wtremmel/MQTTClient/README.md

# MQTTClient
ESP8266 MQTT Client for sensor reading

# Hardware
## Supported Sensors
* BME280 - Temperature, humidity, air pressure
* BME680 - Temperature, humidity, air pressure, air quality
* GY49 - light level
* TSL2561 - light level
* TSL45315 - light level
* VEML6070 - UV light level
* SI7021 - Temperature, humidity
* SDS011 - dust (via soft serial interface)
* ADXL345 - acceleration
* ADC1115 - A/D converter

## Other supported hardware
* DS3221 - Real Time Clock
* Neopixel RGB LEDs

## Parts List Indoor Version
* ESP8266 Microcontroller incl. USB port for easier programming
* BME280 Temperature/Pressure/Humidity Sensor
* TSL2561 Light sensor
* WS2812 RGP LEDs (as many as you need)
* PIR motion sensor (not used in Example)
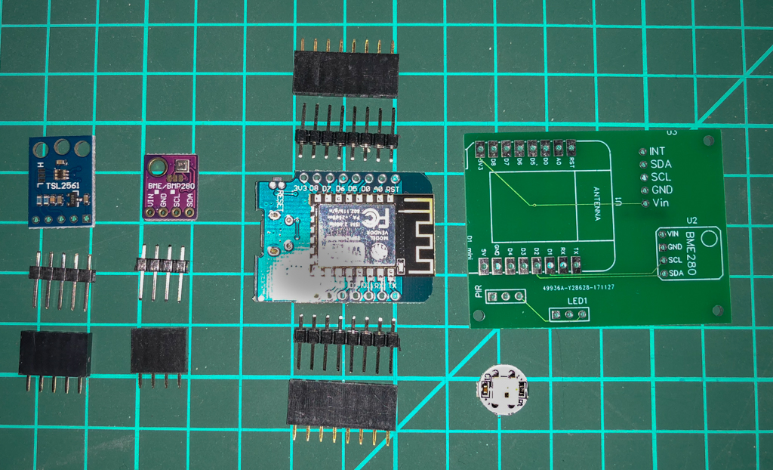
[picture p1: pictures/wt-mqttclient-13.jpg]
Parts
* See parts photo 

## Parts List Outdoor Version
* ESP8266 Microcontroller incl. USB port for easier programming
* BME280 Temperature/Pressure/Humidity Sensor
* TSL45315 Light sensor
* Solar panel 3-5W (the lower the voltage the better)
* Battery holder for two AA cells
* Two AA Eneloop cells (enough for three cloudy days)
* 3.3V step down converter (depending on solar panel used)
* 3.3V voltage regulator (to prevent battery discharge via the regulator)

# Soldering
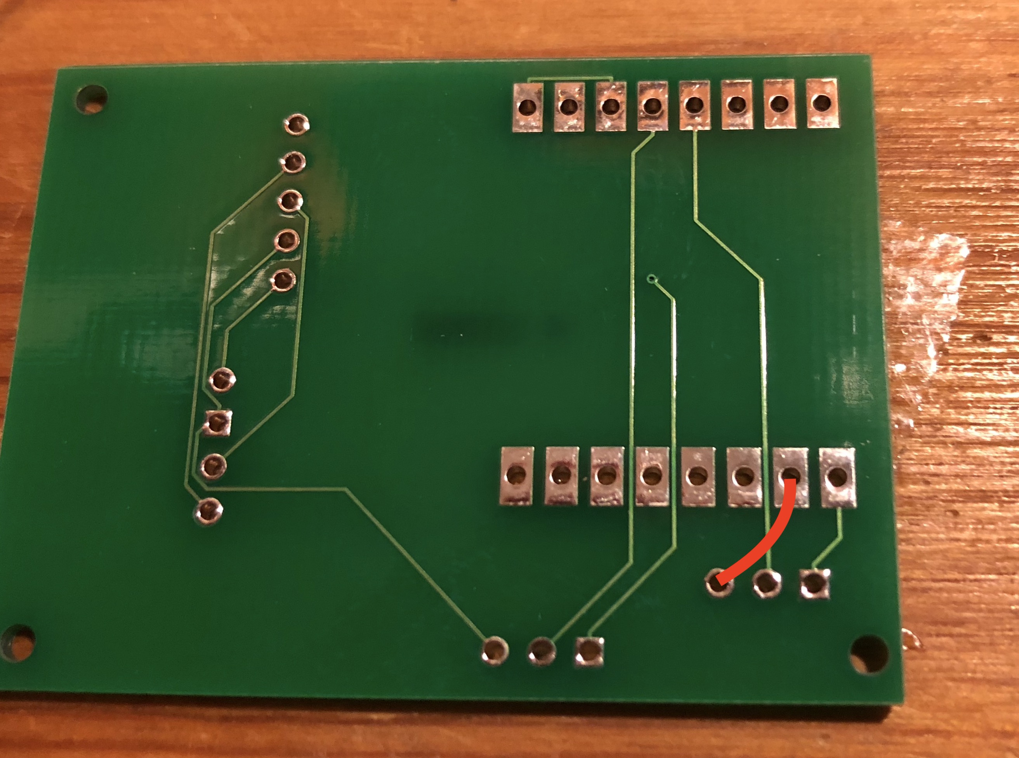
[picture p2: pictures/wt-mqttclient-18.jpg]
Forgotten wire
PIR is not used in this example. Because I made a mistake with the PCB board, you must solder a wire from the D1mini GND pin to the GND pin of the sensors. 

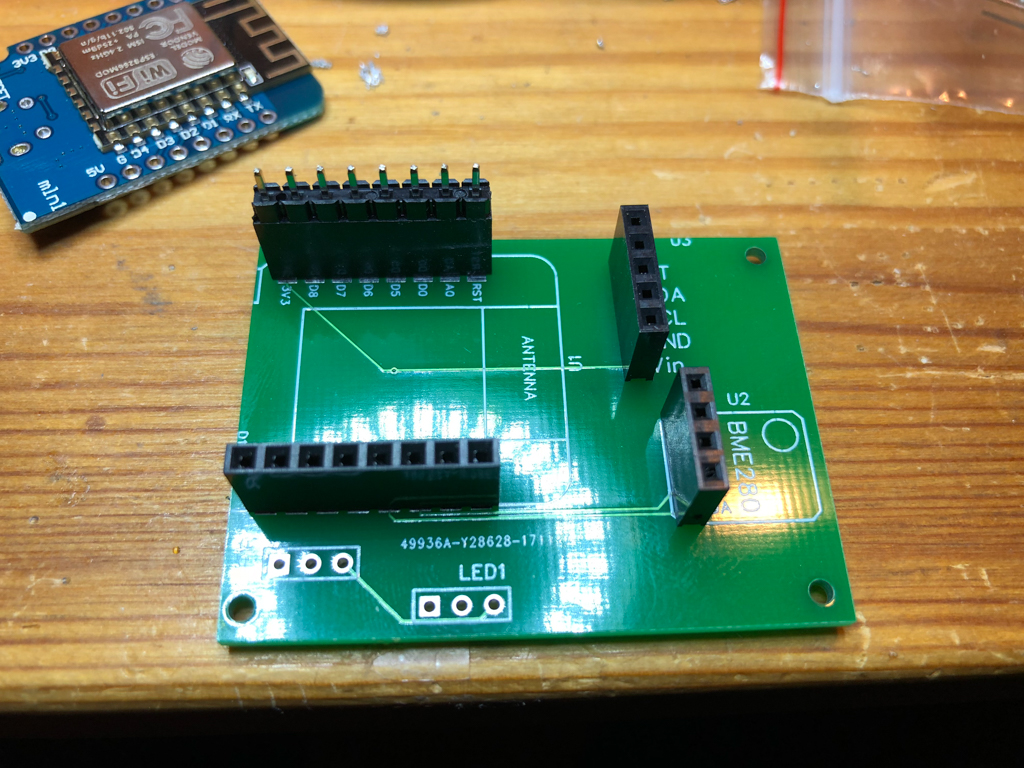
[picture p3: pictures/wt-mqttclient-14.jpg]
Pin Headers
1. First solder the pin headers 
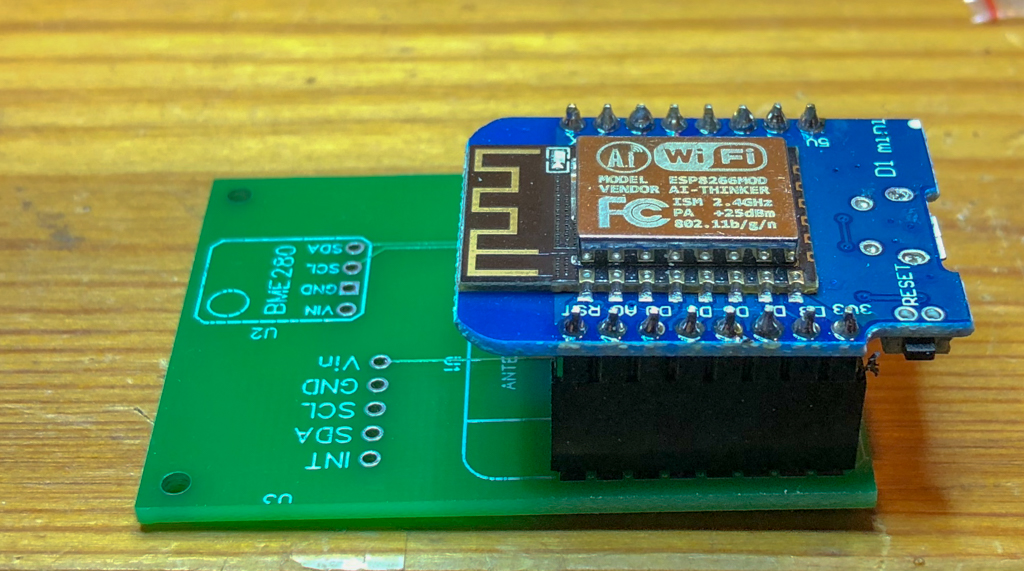
[picture p4: pictures/wt-mqttclient-12.jpg]
D1mini
2. Next plug in the D1mini including the male pin headers and solder the male pin headers to the D1mini from the top 
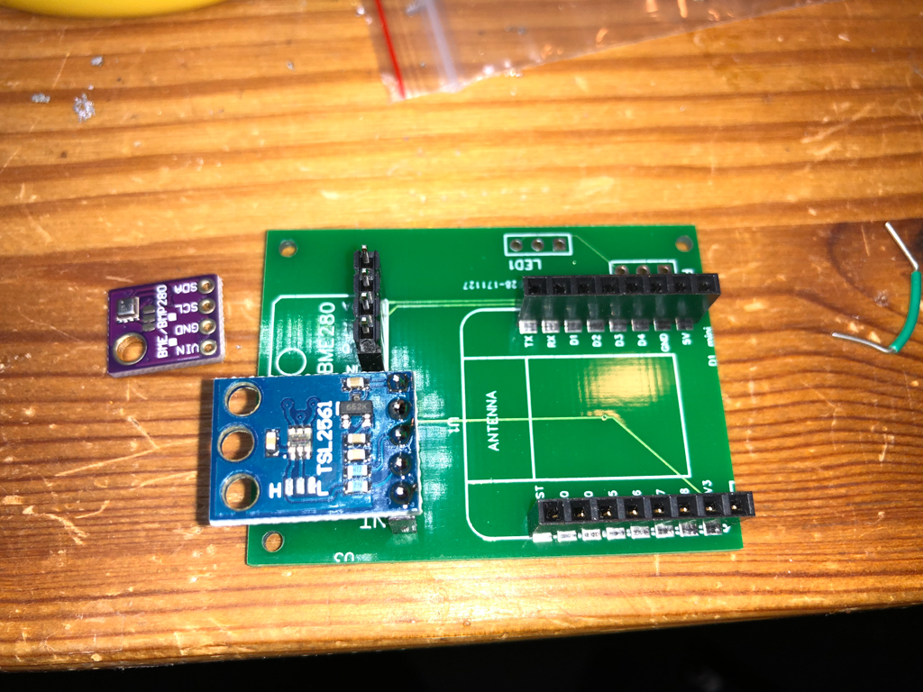
[picture p5: pictures/wt-mqttclient-15.jpg]
Sensors
3. Do the same with the two sensors 
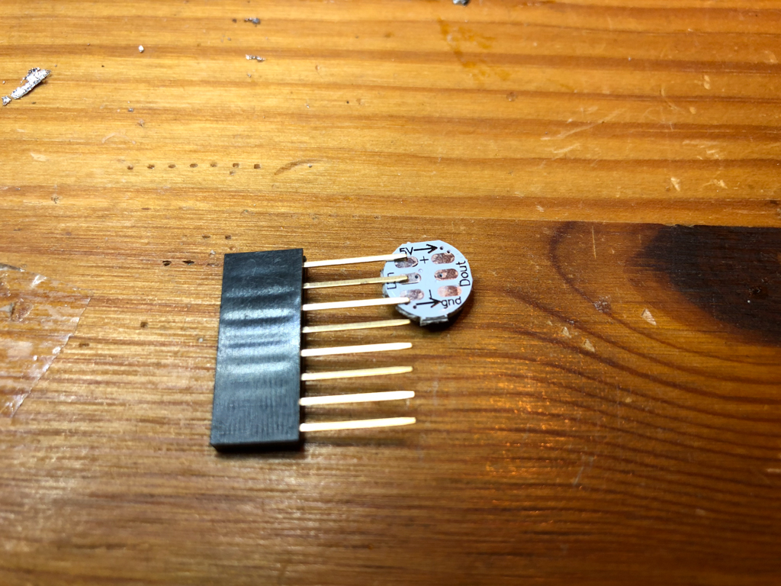
[picture p6: pictures/wt-mqttclient-16.jpg]
LED
4. Depending on what type of LED you have solder the LED 
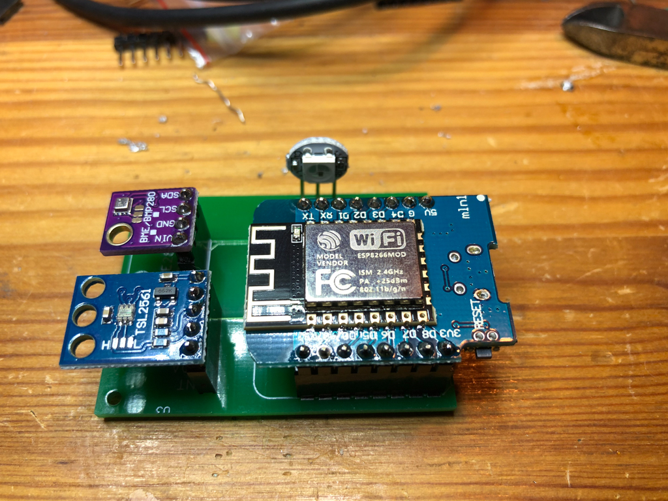
[picture p7: pictures/wt-mqttclient-17.jpg]
Complete
5. Finished module 

# Software
## Config files
Create a directory named *data* within your Arduino project directory.
This directory should contain the following files, each file should only contain one string:
* site   
  Name of the site. Like 'MyHouse'.
* location  
  Name of the location within the site. Like 'Kitchen'.
* myname  
  Hostname of the sensor. Like 'sensor3'.
* mqttserver  
  Name of the mqttserver to connect to. Like 'myserver.local' or '192.168.1.5'
* mqttuser  
  Username when connecting to the mqttserver. Like 'sensor3'.
* mqttpass  
  Password when connecting to the mqttserver. Be aware that this is sent unencrypted!
* mqttport  
  TCP port of the mqttserver. Use 1883 if in doubt.
* ssid   
  Wifi network name to connect to.
* pass   
  WPA2 password of the wifi network.

Then use the *Tools* -> *ESP8266 Sketch Data Upload* menuitem to upload the files.

Compile the software and also upload it to the sensor. If everything is ok and if you have included a LED the LED color will tell you the status when booting:
* Red: Just booting
* Yellow: Connected to Wifi
* Green: Connected to MQTT server
* Off: up and running
