wtremmel/MQTTClient/WeatherSensor.pdf

Weather Sensor - Outdoor Version

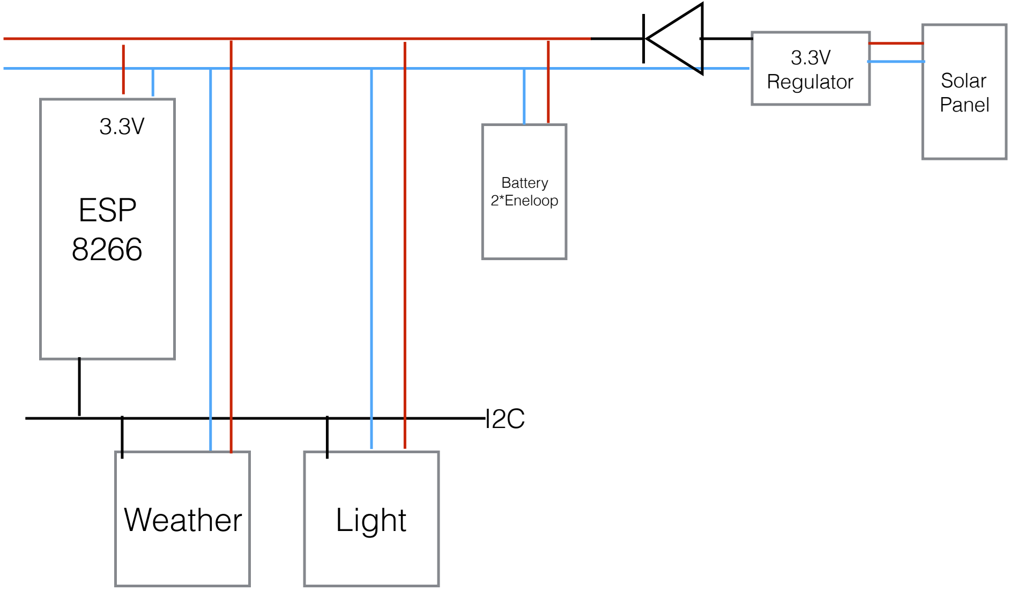
[picture p8: figure]
ESP 8266; Weather; Light; Battery 2*Eneloop; Regulator; Solar; Panel

Weather Sensor - Indoor Version

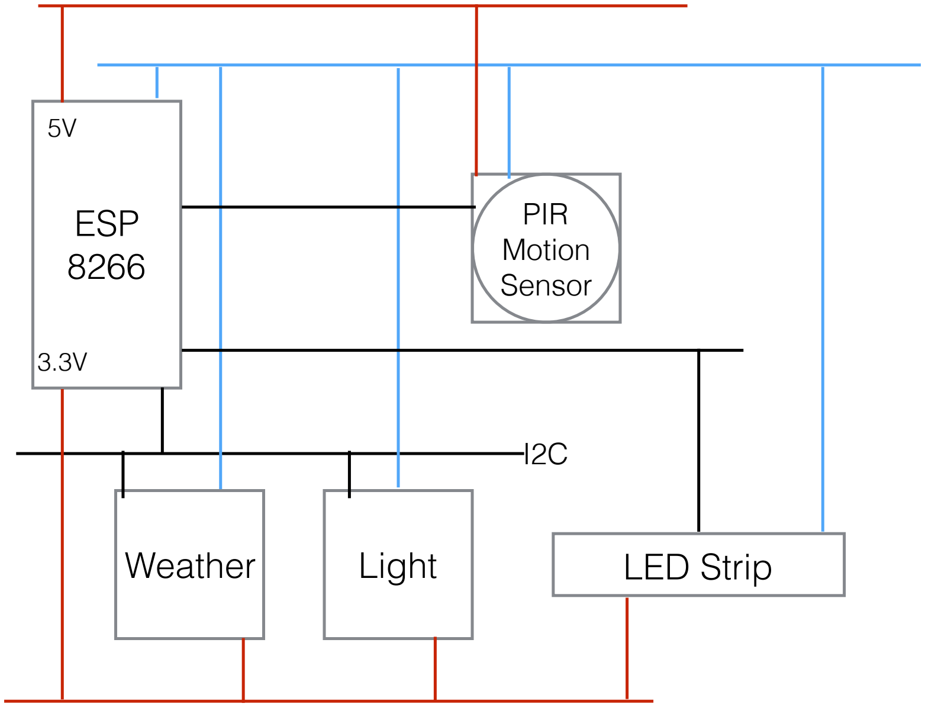
[picture p9: figure]
ESP 8266; Weather; Light; PIR Motion Sensor; LED Strip
