wtremmel/MQTTClient/IMG_0794.jpg

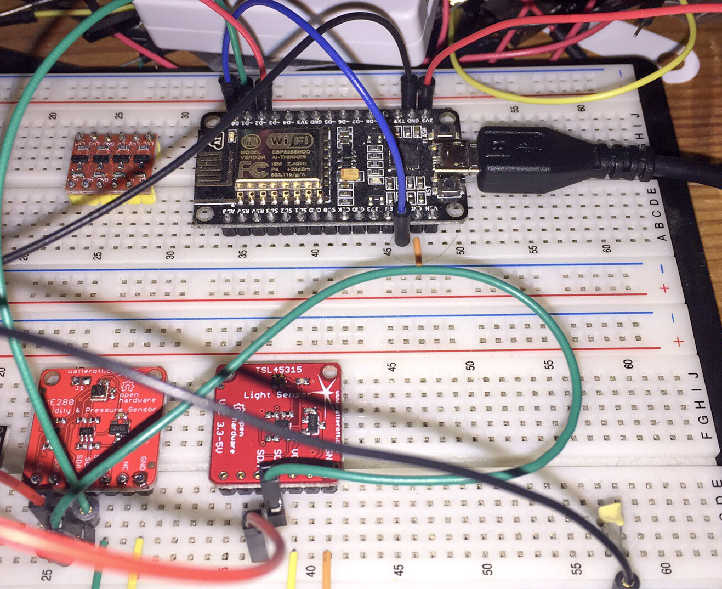
IMG_0794.jpg
