wtremmel/MQTTClient/IMG_0795.jpg

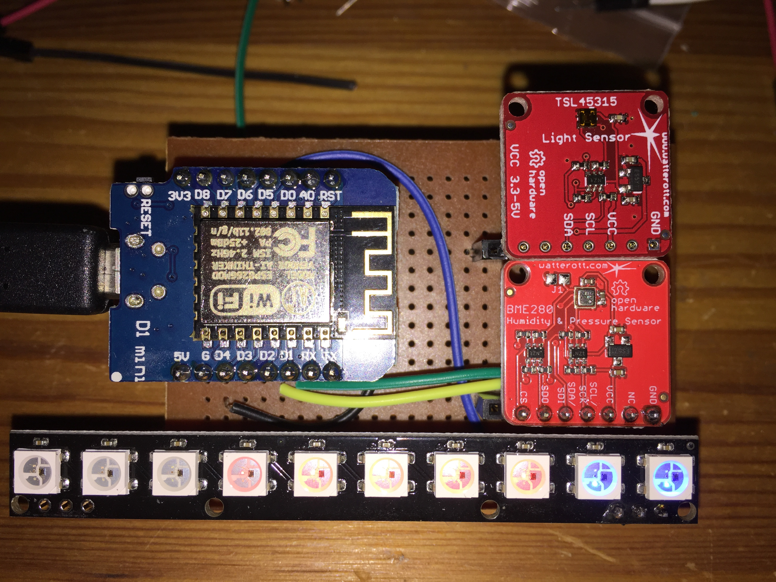
IMG_0795.jpg
