wtremmel/MQTTClient/(threads)

Thread 1 (2018-03-24):

No need to clear the buffer.

Koepel, 2018-03-24:
This code:
```
Wire.requestFrom(LS_I2C_ADDR, 2); //request 2 bytes
l = Wire.read();
h = Wire.read();
while (Wire.available()) {
  Wire.read();  //received more bytes?
}

```
can be as simple as this:
```
Wire.requestFrom(LS_I2C_ADDR, 2); //request 2 bytes
l = Wire.read();
h = Wire.read();
```
There is no need to clear the buffer: [Common-mistakes#4](https://github.com/Koepel/How-to-use-the-Arduino-Wire-library/wiki/Common-mistakes#4)

Thread 2 (2019-09-15):

Serial debug

user-hash, 2019-09-15:
I have problems accesing serial debug information. I uncommented the line after serial.begin, but still no debug entries. I connected the led and it shows yellow light, but its not connected to wifi. Any ideas?
I compiled the code normally and uploaded data folder too.
Thanks!

wtremmel, 2019-09-17:
I did a complete rewrite at https://github.com/wtremmel/esp8266-mqtt-sensor-client - please check this

Closed 2019-09-24.
