wtremmel/MQTTClient/(commit log)

2017-03-27 added voltage monitoring
2017-03-29 added diode
2017-03-30 added power down code
2017-04-02 LED and Website added
2017-04-22 all kind of changes found a bug with voltage reading
    [MQTTClient.ino]
2017-04-23 Voltage only monitored in outdoor version
2017-04-28 bugfix in Stau routine
    [MQTTClient.ino]
2017-05-15 added UV sensor
2017-08-14 added soil sensor
2017-11-04 changed Wifi Mode changed timings when on battery
2017-12-17 added GY49 sensor
2018-01-17 completed soldering
2018-02-10 added more sensors
2018-03-09 added all kind of LED related stuff
